abdullahsahruri/tinker/docs/poster/tinker_socc2026_poster.pdf

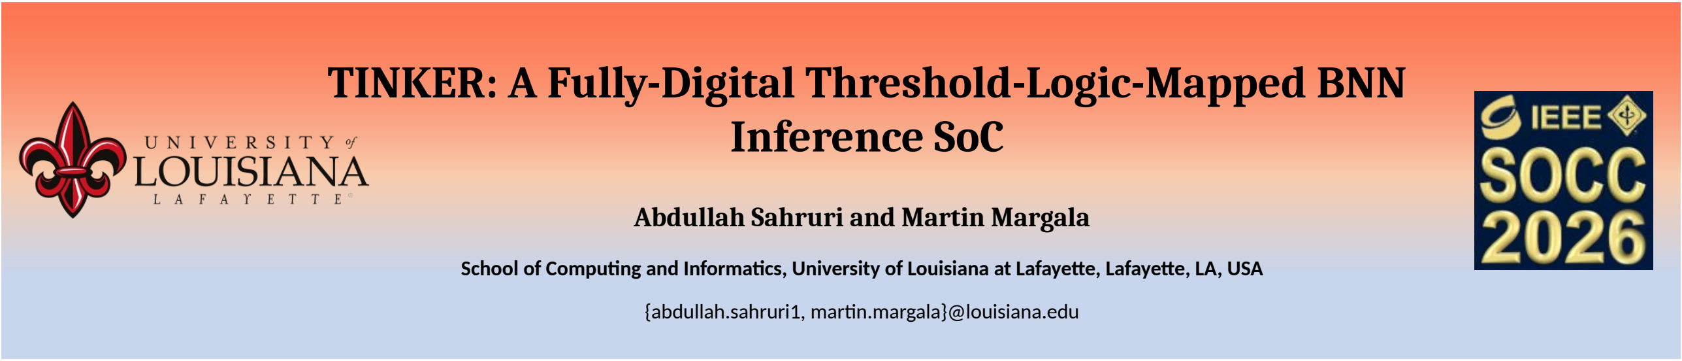
[picture p5: figure]
Inference SoC; Abdullah Sahruri and Martin Margala

# TINKER: A Fully-Digital Threshold-Logic-Mapped BNN

School of Computing and Informatics, University of Louisiana at Lafayette, Lafayette, LA, USA

## {abdullah.sahruri1, martin.margala}@louisiana.edu

85.60 %

## MNIST accuracy

full 10 000-image test set 95 % Wilson CI [84.90, 86.27]

# 8.06 µJ

## per inference

17 068 cycles, 170.7 µs
at 100 MHz

# 47.21 mW

## post-P&R SoC power

activity-aware, 2.25 mm² die, sky130A open flow

24.3 %

## of SoC power in the TLG tile

largest active datapath bucket

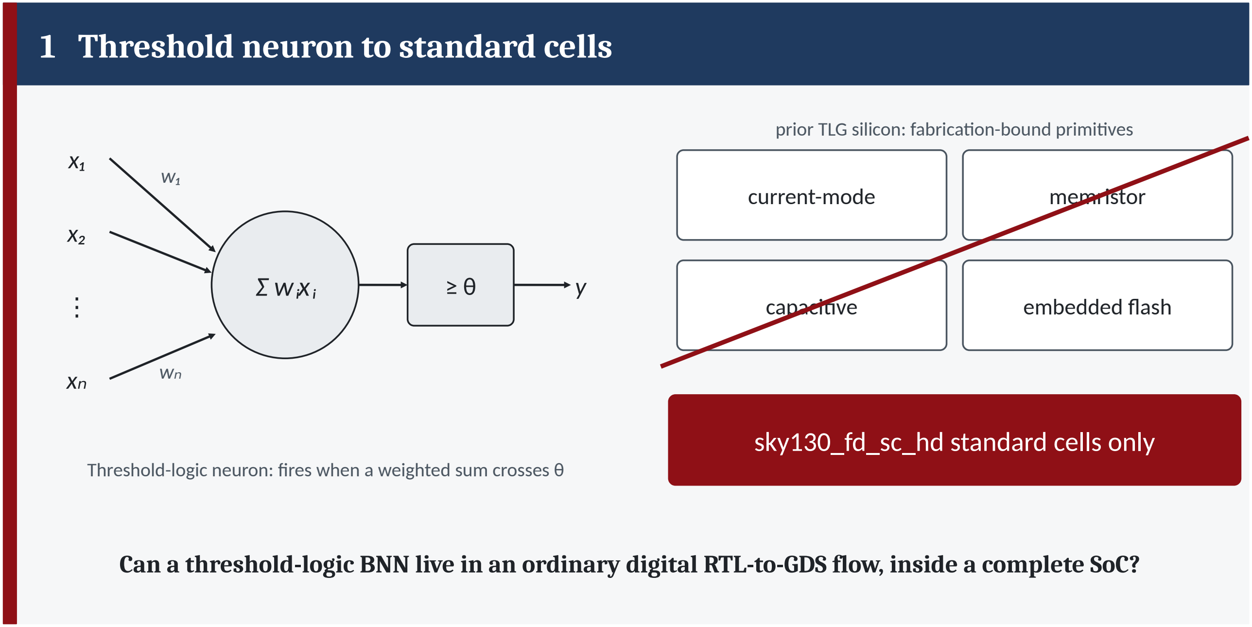
[picture p6: figure]
1 Threshold neuron to standard cells; Σ wᵢxᵢ; prior TLG silicon: fabrication-bound primitives; current-mode; memristor; capacitive; embedded flash; sky130_fd_sc_hd standard cells only

Threshold-logic neuron: fires when a weighted sum crosses θ

Can a threshold-logic BNN live in an ordinary digital RTL-to-GDS flow, inside a complete SoC?

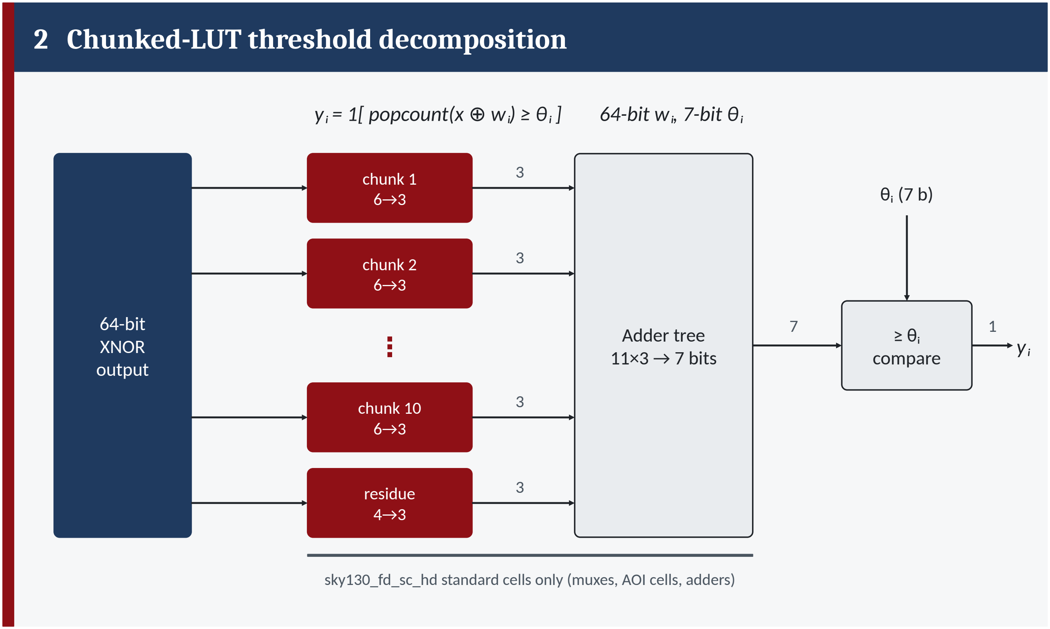
[picture p7: figure]
2 Chunked-LUT threshold decomposition; chunk 2 6→3

yᵢ = 1[ popcount(x wᵢ) ≥ θᵢ ] 64-bit wᵢ, 7-bit θᵢ ⊕ 3 chunk 1 θᵢ (7 b) 6→3 64-bit 7 1 Adder tree ≥ θᵢ ⋮ XNOR yᵢ 11×3 → 7 bits compare output 3 chunk 10 6→3 3 residue 4→3 sky130_fd_sc_hd standard cells only (muxes, AOI cells, adders)

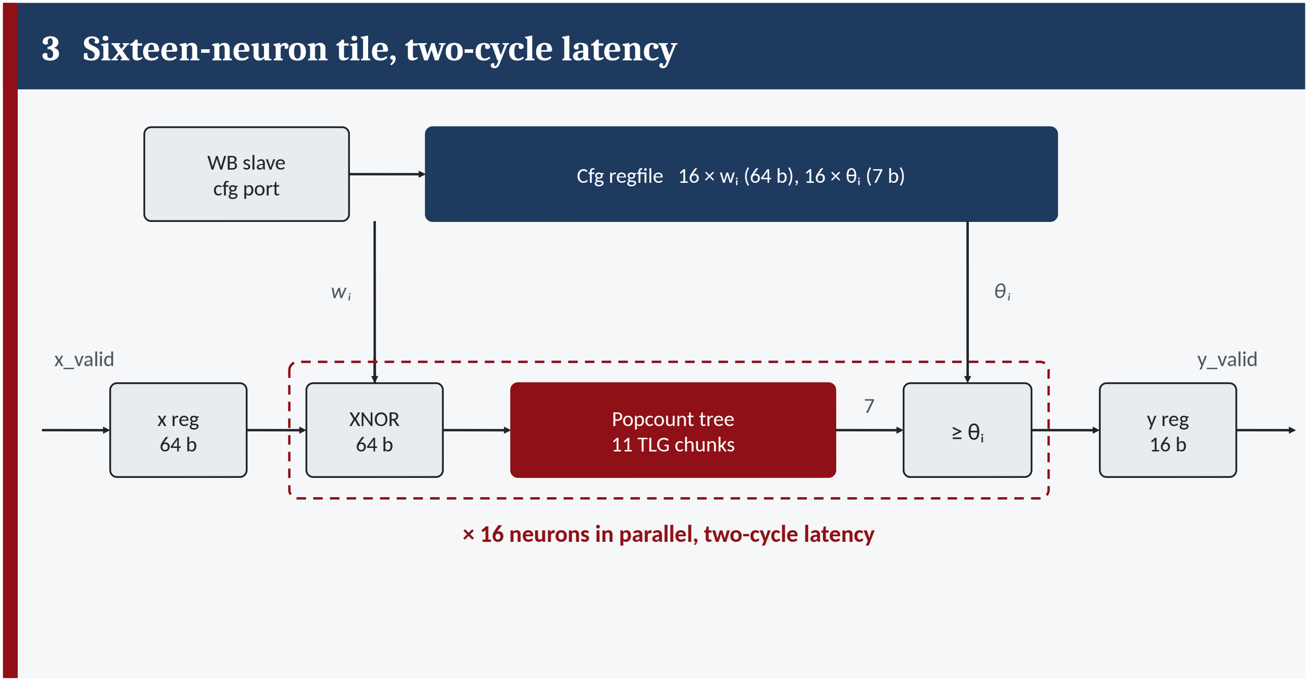
[picture p8: figure]
x_valid; y_valid

# 3 Sixteen-neuron tile, two-cycle latency

WB slave cfg port x reg XNOR 64 b 64 b | Cfg regfile 16 × wᵢ (64 b), 16 × θᵢ (7 b) 7 Popcount tree y reg 11 TLG chunks ≥ θᵢ 16 b × 16 neurons in parallel, two-cycle latency

# 4 Energy per inference vs. prior BNN silicon (log scale)

XNE, 22 nm | 51.2 % ImageNet
YodaNN, 65 nm | ~56 % ImageNet
TULIP (TLG, flash), 40 nm | 89.85 % CIFAR-10
TINKER, sky130A | 85.60 % MNIST, full open-flow SoC
OpenSpike (SNN), sky130 | 99.12 % MNIST, core only
ChewBaccaNN, 22 nm FDX | 86.8 % CIFAR-10
0.1 | 1 | 10 | 100 | 1000
| | µJ per inference

Nodes, networks and reporting scope differ; positioning, not a ranking. 124 113 inferences/J, 5 860 inf/s.

# 5 Post-P&R floorplan on sky130A, 1.5 × 1.5 mm die

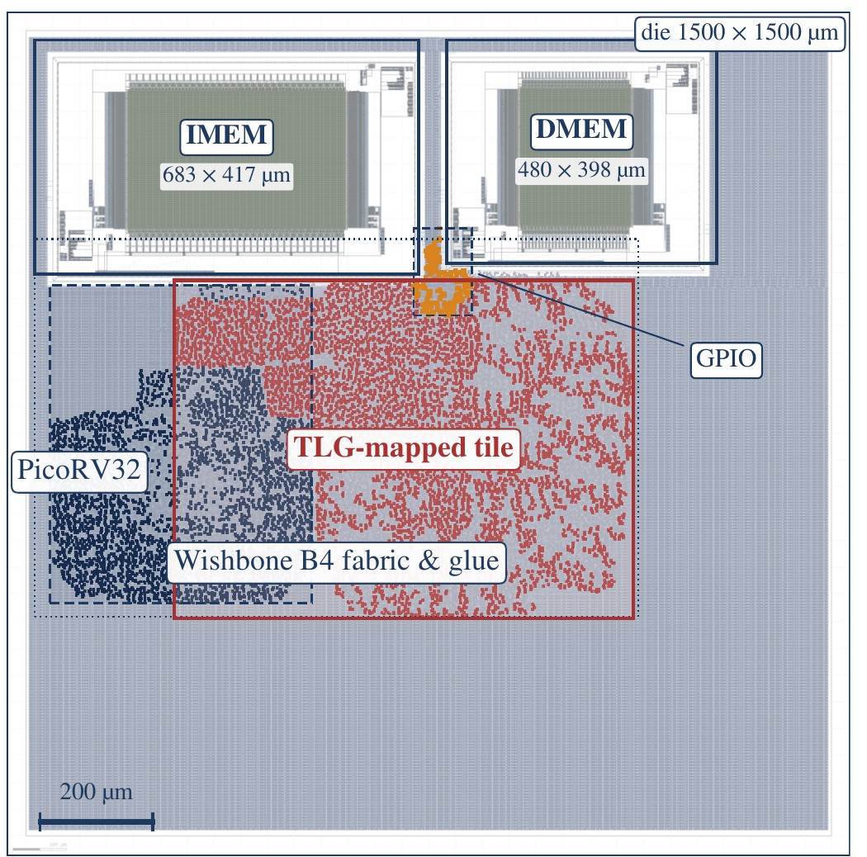
[picture p9: figure]

LibreLane flow: Yosys, OpenROAD, Magic, KLayout, Netgen. OpenRAM IMEM (2 KB) and DMEM (1 KB) macros top; TLG tile, PicoRV32, and fabric below. Nine-corner STA; TT closes at +0.51 ns setup, +0.37 ns hold.

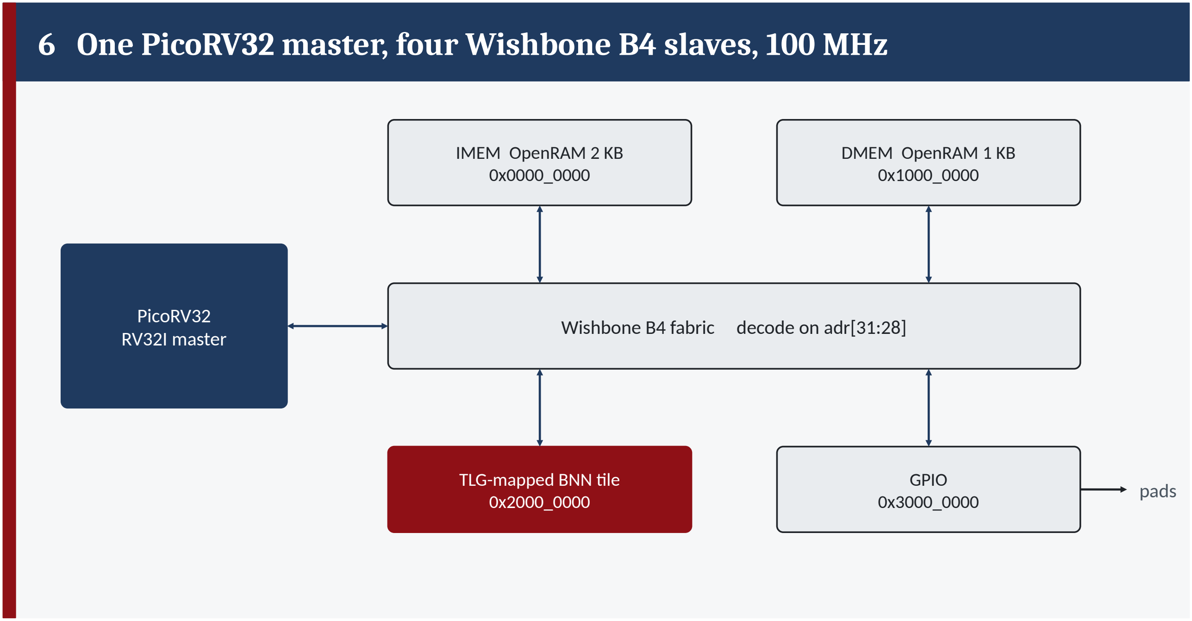
[picture p10: figure]

# 6 One PicoRV32 master, four Wishbone B4 slaves, 100 MHz

IMEM OpenRAM 2 KB DMEM OpenRAM 1 KB 0x0000_0000 0x1000_0000 PicoRV32 Wishbone B4 fabric decode on adr[31:28] RV32I master TLG-mapped BNN tile GPIO pads 0x2000_0000 0x3000_0000

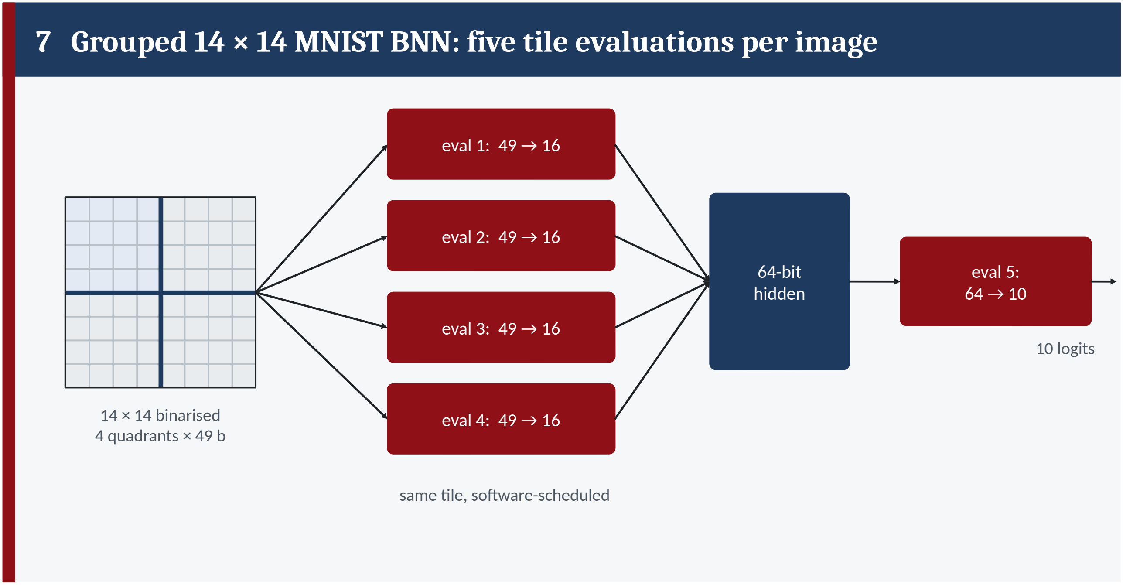
[picture p11: figure]
14 × 14 binarised 4 quadrants × 49 b; eval 2: 49 → 16; eval 3: 49 → 16; 64-bit hidden; eval 5: 64 → 10; 10 logits

# 7 Grouped 14 × 14 MNIST BNN: five tile evaluations per image

| eval 1: 49 → 16 eval 4: 49 → 16 same tile, software-scheduled
| 8 Where the SoC power goes (post-P&R, VCD-annotated)
| Register-file baseline (pre-OpenRAM): 106.06 mW
clock | 10.8 % | CPU | memory 36.4 %
clock | 24.3 % | CPU | mem | OpenRAM macros (this work): 47.21 mW same tile netlist, 11.47 mW
0 | 20 | 40 | 60 | 80 | 100 mW

OpenRAM halves SoC power; the unchanged tile rises from 10.8 % to 24.3 % and becomes the largest active datapath bucket.

IEEE 39th International System-on-Chip Conference (SOCC 2026), Heidelberg, Germany

paper + poster (Drive)
