abdullahsahruri/tinker/paper/figures/fig4_power_breakdown.pdf

0 | 20 | 40 | 60 | 80 | 100
Power (mW) at max_ff_n40C_1v95
| | 10.8% | | total 106.06 mW regfile baseline

same Tile RTL (11.47 mW)

| 24.3% | | total 47.21 mW OpenRAM macros

(pre-OpenRAM)

(this work)

Clock | Tile | CPU | IMEM | DMEM Shared | GPIO | Other
