abdullahsahruri/tinker/camera-ready/tables/table2_comparison.tex

% Table II — Comparison vs prior digital BNN/threshold-logic ASICs and
% the closest open-flow neural-inference comparator. Numeric cells for
% cited rows are populated from the cited papers' canonical PPA tables;
% see comments above each row for the verifying source.
\begin{table}[!t]
  \centering
  \caption{BNN/threshold-logic accelerator positioning. Designs differ in
  node, network, voltage, and reporting scope; the table is not a direct
  efficiency ranking. \textsuperscript{$\dagger$}~inherited training-method
  accuracy; \textsuperscript{$\ddagger$}~core dynamic energy only.}
  \label{tab:comparison}
  \scriptsize
  \renewcommand{\arraystretch}{1.15}
  \setlength{\tabcolsep}{3pt}
  \begin{tabular}{@{}llllll@{}}
    \toprule
    \textbf{Ref.} & \textbf{Tech.} & \textbf{Network} & \textbf{Acc.} & \textbf{E/inf.} & \textbf{Area} \\
    \midrule
    \cite{conti2018xnor}          & 22\,nm        & ResNet-18 IN     & 51.2\,\%               & 1\,450\,\textmu J               & 2.32\,mm$^2$ \\
    \cite{andri2018yodann}       & UMC 65\,nm    & AlexNet IN       & $\sim$56\,\%$^\dagger$ & 352\,\textmu J                  & 1.9\,mm$^2$  \\
    \cite{wagle2020tulip}            & 40\,nm        & BinaryNet C10    & 89.85\,\%$^\dagger$    & 184\,\textmu J                  & 1.8\,mm$^2$  \\
    \cite{andri2021chewbaccann}  & GF 22\,nm FDX & VGG-like C10     & 86.8\,\%               & 1.3\,\textmu J                  & 0.7\,mm$^2$  \\
    \cite{modaresi2023openspike}        & sky130        & 1024-1024-10 SNN & 99.12\,\%              & $\sim$2.5\,\textmu J$^\ddagger$ & 33.3\,mm$^2$ \\
    \midrule
    \textbf{This work}      & sky130A       & 14$\times$14 BNN & \textbf{85.60\,\%}     & \textbf{8.06\,\textmu J}        & 2.25\,mm$^2$ \\
    \bottomrule
  \end{tabular}
\end{table}
