abdullahsahruri/tinker/paper/figures/fig_tlg_decomp.pdf

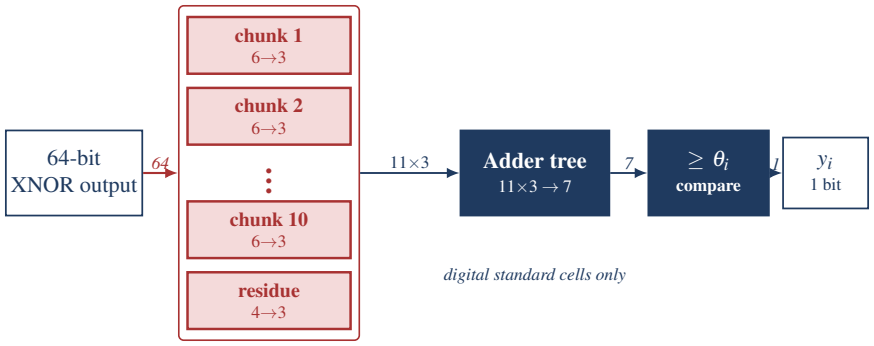
[picture p17: figure]
64-bit XNOR output; chunk 1 6→3; chunk 2 6→3 . . .; chunk 10 6→3; residue 4→3; Adder tree; compare; 1 bit; digital standard cells only
