abdullahsahruri/tinker/paper/figures/fig2_tile_microarch.pdf

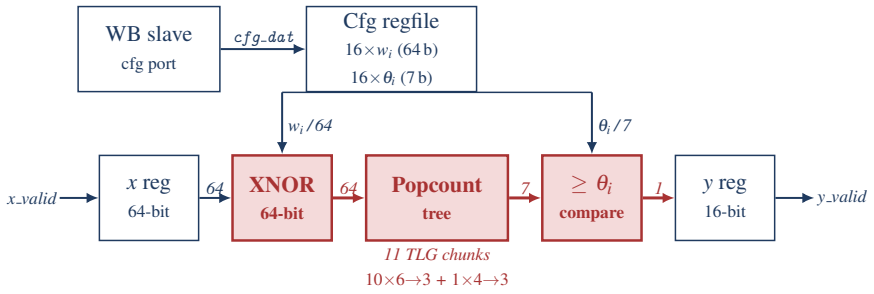
[picture p18: figure]
WB slave; cfg port; Cfg regfile; cfg dat; x reg; 64-bit; XNOR; Popcount; tree; compare; y reg; 16-bit; 11 TLG chunks; x valid; y valid

threshold function via TL decomposition (sky130 fd sc hd muxes & AOI cells)

## ×16 neurons in parallel → 16-bit output / cycle
