abdullahsahruri/tinker/paper/figures/fig1_soc_block.pdf

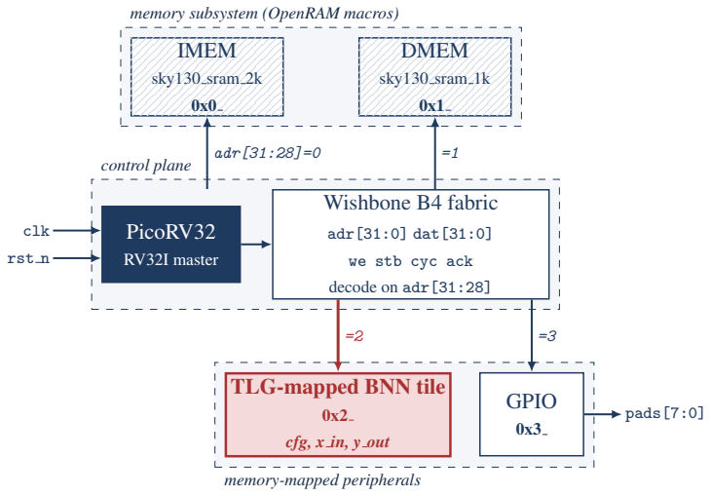
[picture p19: figure]
IMEM; sky130 sram 2k; DMEM; sky130 sram 1k; memory subsystem (OpenRAM macros); PicoRV32; RV32I master; Wishbone B4 fabric; adr[31:0] dat[31:0]; we stb cyc ack; decode on adr[31:28]; control plane; TLG-mapped BNN tile; cfg, x in, y out; GPIO; memory-mapped peripherals; adr[31:28]=0; clk; rst n; pads[7:0]
