abdullahsahruri/tinker/paper/figures/fig3_layout_v2_OLD.pdf

## IMEM

683 × 417 µm

## DMEM

480 × 398 µm

### TLG-mapped tile

681 × 503 µm

### PicoRV32

GPIO

Wishbone B4 fabric
routed across std-cell rows

die 1500 × 1500 µm

200 µm
