abdullahsahruri/tinker/paper/figures/fig3_layout_klayout_OLD.pdf

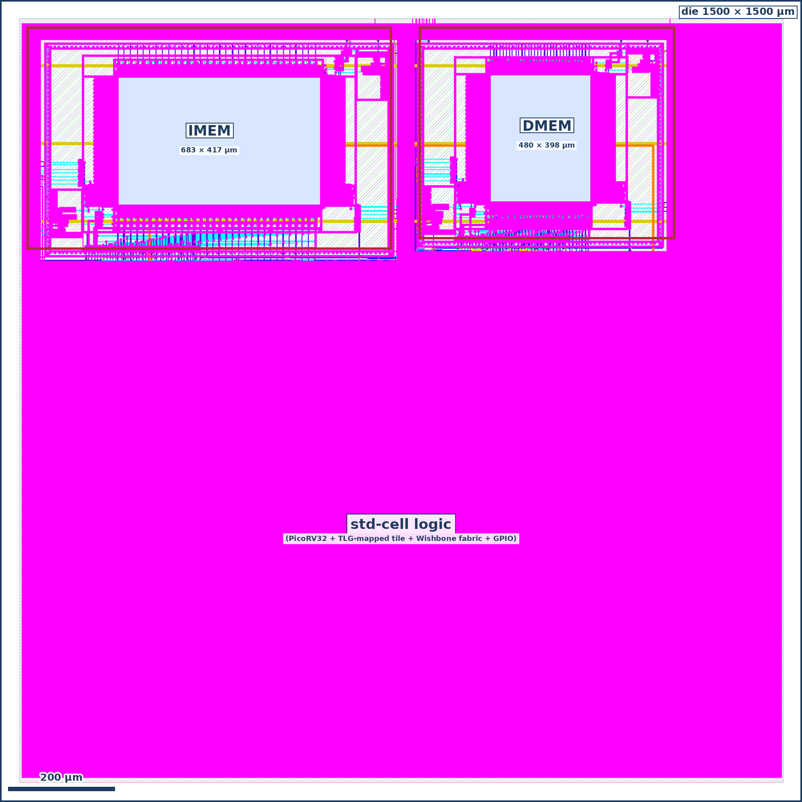
[picture p20: page 1]
