abdullahsahruri/tinker/paper/figures/src/fig3_base.png

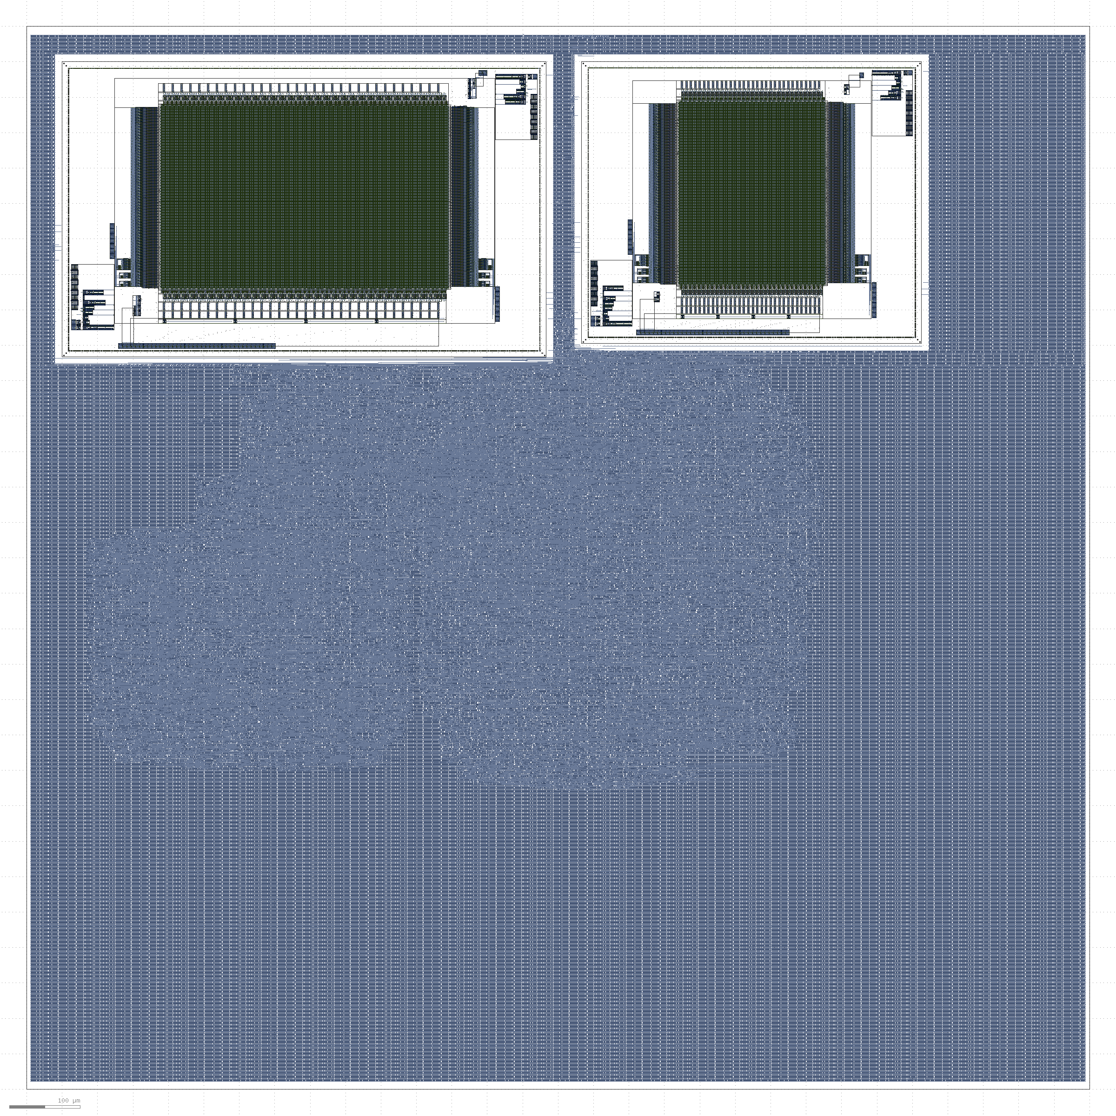
paper/figures/src/fig3_base.png
