abdullahsahruri/tinker/camera-ready/tables/table1_verification.tex

% Table I — Functional verification summary (4 gates).
% Numbers locked from PHASE4_5_NOTES.md §6 and PHASE3_5_NOTES.md §3.
\begin{table}[t]
  \centering
  \caption{Functional verification summary.}
  \label{tab:verification}
  \renewcommand{\arraystretch}{1.15}
  \begin{tabular}{@{}>{\raggedright\arraybackslash}p{0.36\columnwidth}>{\raggedright\arraybackslash}p{0.27\columnwidth}>{\raggedright\arraybackslash}p{0.27\columnwidth}@{}}
    \toprule
    \textbf{Gate} & \textbf{Reference} & \textbf{Result} \\
    \midrule
    PyTorch $\leftrightarrow$ integer golden & integer model & 15/16 (1 boundary) \\
    SoC sim $\leftrightarrow$ integer golden & RTL simulation & 16/16 PASS         \\
    Full MNIST 10\,K eval                    & vectorized integer model    & 85.60\,\% [84.90, 86.27] \\
    DRC / LVS / XOR / antenna               & KLayout, Netgen             & 0 / 0 / 0 / 0      \\
    \bottomrule
  \end{tabular}
\end{table}
