abdullahsahruri/tinker/results/phase4_prep/full_mnist_accuracy_14x14.md

# Phase 4.5 Stage 1 — Full MNIST Test-Set Accuracy

**Network**: 4×(49→16,BN,sign)→64→10 grouped BNN (14×14 grouped preprocessing, hard-tanh STE, OneCycleLR 30 ep, 3-seed best).

## Headline Result

| Metric | Value |
|---|---|
| Test images | 10,000 |
| Correct | 8,560 |
| **Accuracy** | **85.60%** |
| 95% Wilson CI | [84.90%, 86.27%] |
| Phase-3D 7×7 BNN | 71.12% |
| Phase-4.5 initial 14×14 | 80.73% |
| Delta vs initial | +4.87 pp |

## Per-Class Accuracy

| Digit | Correct | Total | Accuracy |
|---|---|---|---|
| 0 | 900 | 980 | 91.8% |
| 1 | 1080 | 1135 | 95.2% |
| 2 | 876 | 1032 | 84.9% |
| 3 | 864 | 1010 | 85.5% |
| 4 | 787 | 982 | 80.1% |
| 5 | 670 | 892 | 75.1% |
| 6 | 871 | 958 | 90.9% |
| 7 | 889 | 1028 | 86.5% |
| 8 | 782 | 974 | 80.3% |
| 9 | 841 | 1009 | 83.3% |

## Confusion Matrix

Rows = true class, columns = predicted class.

| True \ Pred | 0 | 1 | 2 | 3 | 4 | 5 | 6 | 7 | 8 | 9 |
|---|---|---|---|---|---|---|---|---|---|---|
| **0** | 900 | 1 | 11 | 14 | 3 | 3 | 14 | 4 | 30 | 0 |
| **1** | 0 | 1080 | 11 | 1 | 1 | 9 | 8 | 2 | 23 | 0 |
| **2** | 15 | 8 | 876 | 20 | 14 | 3 | 19 | 18 | 53 | 6 |
| **3** | 16 | 5 | 27 | 864 | 3 | 24 | 11 | 19 | 25 | 16 |
| **4** | 3 | 5 | 12 | 5 | 787 | 7 | 24 | 13 | 14 | 112 |
| **5** | 26 | 17 | 11 | 68 | 27 | 670 | 22 | 4 | 30 | 17 |
| **6** | 25 | 3 | 11 | 3 | 7 | 27 | 871 | 4 | 6 | 1 |
| **7** | 7 | 12 | 23 | 9 | 13 | 3 | 1 | 889 | 18 | 53 |
| **8** | 18 | 8 | 26 | 57 | 8 | 35 | 14 | 12 | 782 | 14 |
| **9** | 13 | 7 | 5 | 16 | 44 | 6 | 1 | 54 | 22 | 841 |

*Eval time: 0.1s on CPU.*
