abdullahsahruri/tinker/results/phase1/summary.csv

variant | seed | area_um2 | stdcell_count | fmax_mhz | power_uw_at_100mhz | ws_at_slow_ns | drc_errors | lvs_errors | run_dir
naive | 0 | 8051.47 | 492 | 110.27513865626167 | 3084.24886316061 | 0.931772907426604 | 0 | 0 | flow/phase1_naive/seed0/runs/phase1_naive_s0
naive | 1 | 8051.47 | 493 | 108.93401226414832 | 3240.9646082669497 | 0.820130653269679 | 0 | 0 | flow/phase1_naive/seed1/runs/phase1_naive_s1
naive | 2 | 8051.47 | 502 | 99.89087326782106 | 2951.8872033804655 | -0.010924594871280184 | 0 | 0 | flow/phase1_naive/seed2/runs/phase1_naive_s2
naive | 3 | 8051.47 | 490 | 111.49400422581039 | 3251.7046201974154 | 1.0309078327235803 | 0 | 0 | flow/phase1_naive/seed3/runs/phase1_naive_s3
naive | 4 | 8092.76 | 498 | 99.1800620657252 | 3043.002914637327 | -0.08267164964380158 | 0 | 0 | flow/phase1_naive/seed4/runs/phase1_naive_s4
handopt | 0 | 7767.45 | 494 | 105.53117846091443 | 3011.635970324278 | 0.5241274229646753 | 0 | 0 | flow/phase1_handopt/seed0/runs/phase1_handopt_s0
handopt | 1 | 8051.47 | 502 | 104.03753270606951 | 3030.611900612712 | 0.3880842423932235 | 0 | 0 | flow/phase1_handopt/seed1/runs/phase1_handopt_s1
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
