abdullahsahruri/tinker/results/phase2/summary.csv

variant | seed | cells | area_um2 | fmax_mhz_slow | fmax_mhz_nom | ws_slow_ns | power_total_uw | power_internal_uw | power_switching_uw | power_leakage_uw | drc_violations | lvs_violations | antenna_nets | antenna_pins | run_dir
tlg_hc | 0 | 7184 | 116049.0 | 89.02273422577599 | 146.11681605335892 | -1.2330856684747389 | 26637.7255320549 | 14245.596714317799 | 12392.021715641022 | 0.10854230225731953 | 0 | 0 | 0 | 0 | flow/phase2_tlg_hc/runs/phase2_tlg_hc
tlg_hc | 1 | 7150 | 117765.0 | 85.82350180316844 | 141.62767182868498 | -1.6518200608202394 | 27364.056557416916 | 14622.378163039684 | 12741.568498313427 | 0.11045993630887097 | 0 | 0 | 0 | 0 | flow/phase2_tlg_hc/seed1/runs/phase2_tlg_hc_s1
tlg_hc | 2 | 7124 | 115580.0 | 88.45547156448728 | 143.43722851318134 | -1.3051231575987163 | 26900.874450802803 | 14243.443496525288 | 12657.32292085886 | 0.1077615650046937 | 0 | 0 | 0 | 0 | flow/phase2_tlg_hc/seed2/runs/phase2_tlg_hc_s2
tlg_ld | 0 | 22125 | 320367.0 | 73.81119119452518 | 130.41260815197037 | -3.54808104050993 | 64565.9938454628 | 34599.486738443375 | 29966.194182634354 | 0.3153805891997763 | 0 | 0 | 0 | 0 | flow/phase2_tlg_ld/runs/phase2_tlg_ld
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
