abdullahsahruri/tinker/results/phase3/figures/soc_layout_openram_raw.png

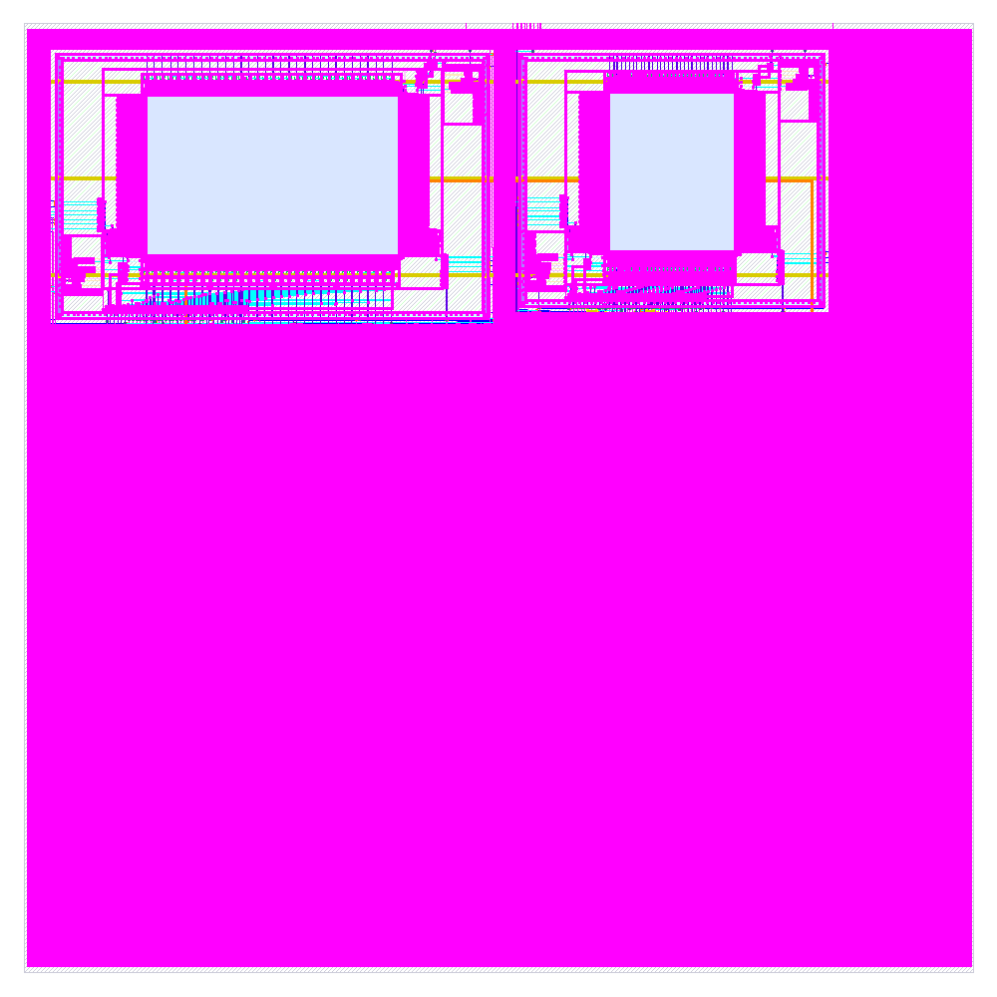
results/phase3/figures/soc_layout_openram_raw.png
