abdullahsahruri/tinker/paper/figures/conventional3.pdf

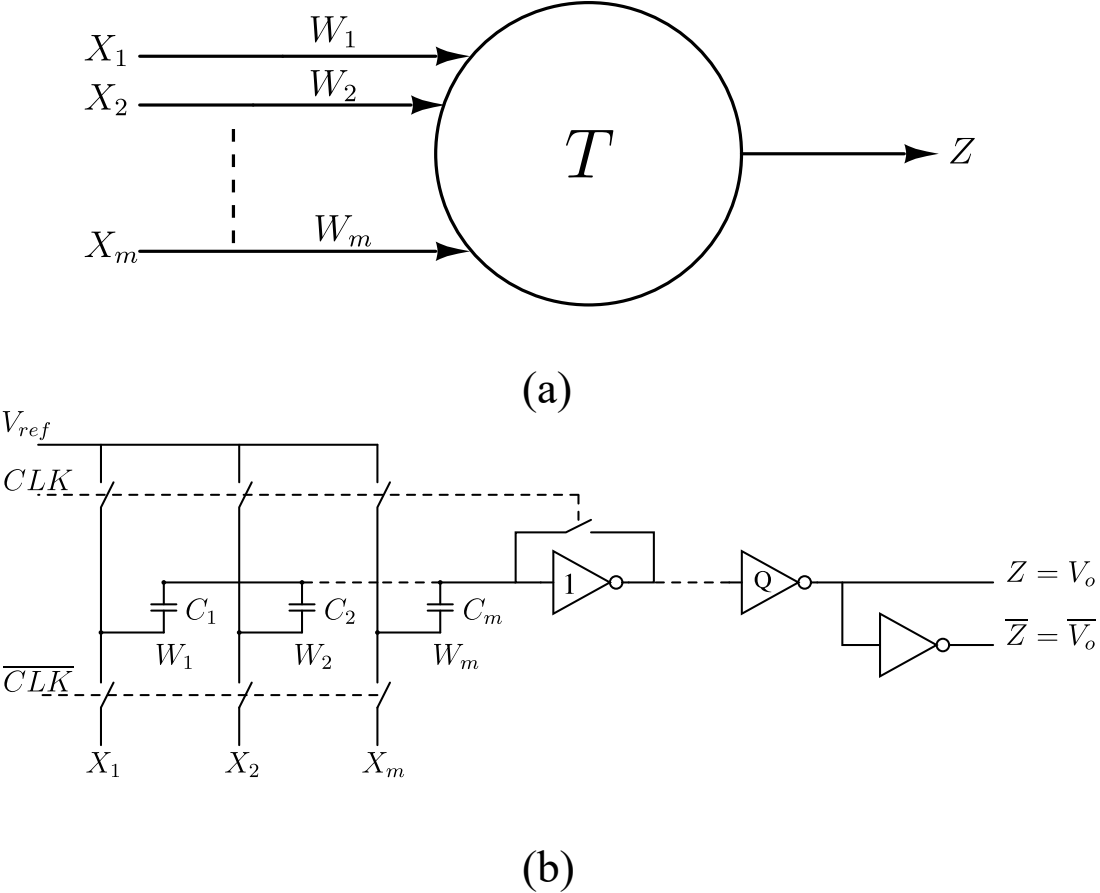
[picture p23: page 1]
