abdullahsahruri/tinker/(commit log)

2026-05-02 Phase 0 complete: toolchain, env.sh, hello-world GDS
    - LibreLane 3.0.3 installed in .venv/, Docker image pulled
    - sky130A PDK at commit 8afc8346a57fe1ab7934ba5a6056ea8b43078e71
    installed locally to ./pdk/ via volare 0.20.6
    - scripts/env.sh: project-local activation, scrubs /mnt/c PATH pollution
    (no system-wide changes)
    - rtl/hello.v + flow/hello/config.json: 4-bit counter end-to-end smoke test
    - results/hello/{hello.gds,metrics.json}: 0 DRC, 0 LVS, +5.46 ns setup slack
    - docs/PHASE0_NOTES.md: pinned versions, .wslconfig RAM advisory for Phase 2
2026-05-03 Phase 1 complete: 15-run TLG vs naive vs hand-opt PPA study
    15 LibreLane flows (3 variants × 5 seeds) all DRC/LVS clean. Headline:
    - Area: C +19% larger than B, +17% larger than A
    - Fmax: C 3% slower than B
    - Power: C 48% lower than B, 51% lower than A
    NO-GO on strict ≥20%-on-≥2-of-3 criterion: TLG wins only on power.
    Power result is large enough to consider re-framing as energy-first.
    Deliverables:
    - scripts/{gen_neuron,gen_tb_data,run_phase1,collect_phase1}.{py,sh}
    - rtl/{naive,handopt,tlg}/neuron_*_s{0..4}.v
    - tb/tb_neuron_s0.v + golden vectors (100/100 match for seed=0)
    - flow/phase1_{naive,handopt,tlg}/{config.json,seed*/}
    - flow/common/neuron.sdc (combinational virtual-clock S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
    [summary.csv]
2026-05-03 Phase 2B: tile-level LibreLane PPA — TLG energy advantage composes
    Four LibreLane runs on sky130A/sky130_fd_sc_hd, identical knobs
    (SYNTH_STRATEGY=AREA 0, FP_CORE_UTIL=35, PL_TARGET_DENSITY_PCT=55),
    new sequential-clock SDC at flow/common/tile.sdc. All four DRC/LVS/
    antenna clean.
    Headline:
    TLG_hc vs handopt_hc: -28.1% power, -31.5% cells, -11.6% area
    TLG_ld vs handopt_ld: -61.5% power (iso-cell, iso-area, iso-Fmax)
    The loadable comparison — the one that matters for a programmable
    tile — beats Phase 1's per-neuron 48% advantage. Hardcoded gap
    (28.1%) is 1.9 pp shy of the strict GO threshold; full GO/MARGINAL
    discussion and Session 2C path forward are in docs/PHASE2B_NOTES.md.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
    [summary.csv]
2026-05-03 Phase 2B.5: 3-seed sweep confirms TLG hc advantage; ≥30% gate passes
    4 new LibreLane runs (tlg_hc, handopt_hc × seed_id 1, 2) on top of
    2B's seed-0 baseline. Loadable variants skipped — their RTL is
    seed-invariant by construction (no weight constants in the .v
    file), so synthesis-time PPA is identical for any seed.
    Headline movement vs single-seed 2B:
    TLG hc vs handopt hc — power: 28.1% → 31.3% (crosses ≥30% gate)
    TLG hc vs handopt hc — cells: 31.5% → 32.0%
    TLG hc vs handopt hc — Fmax: 2.4% → 5.8%
    TLG ld vs handopt ld — power: 61.5% (unchanged, seed-invariant)
    Per-seed picture is dominant: every TLG hc run beats every
    handopt hc run on every measured axis.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
    [summary.csv]
2026-05-03 Phase 2C: activity-aware power — TLG hc resilience widens, ld holds gate
    Two complementary mechanistic findings on the same post-route netlists
    from 2B/2B.5 (no re-synthesis), driven by VCD-extracted boundary
    activity from 1024 random-uniform 64-bit vectors at 1+2 cadence.
    hc — TLG advantage WIDENS 31.2% → 80.25% ± 0.68% (3-seed mean).
    Truth-table case-arms suppress combinational toggle propagation;
    adder-tree carry chains glitch on every input change. 9.6×
    combinational power explosion on handopt_hc vs 3.4× on TLG_hc
    drives the +49 pp jump.
    ld — TLG advantage SHRINKS 61.5% → 49.07% ± 0.10% (3-seed mean).
    ~1100-flop cfg regfile creates an activity-invariant powe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
    [summary.csv]
2026-05-04 Phase 3A: SoC architecture spec + skeleton RTL
    Architecture locked: PicoRV32 RV32I master + Wishbone B4 classic single
    shared bus + 4 slaves (IMEM 8 KB @ 0x0, DMEM 4 KB @ 0x1, TILE 512 B @ 0x2,
    GPIO 16 B @ 0x3), single clock domain, async-assert / sync-deassert reset,
    polled inference handshake on STATUS.BUSY. Address decode on adr[31:28].
    PicoRV32 ↔ WB glue uses upstream picorv32_wb wrapper (vendored in 3C).
    Tile wrapper register bank (PHASE3_ARCHITECTURE.md §4): two-write commit
    for 64-bit weights (LO at 0x000+8i, HI at 0x004+8i — writing HI commits
    to tile cfg via one cfg_we pulse) and for the 64-bit input vector (LO at
    0x100, HI at 0x104 — writing HI pulses x_valid). Thresholds p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
    [picorv32_wrapper.v, soc_top.v, wb_dmem.v, wb_gpio.v, wb_imem.v, wb_interconnect.v, wb_tile_wrapper.v]
2026-05-04 Phase 3B: tile wrapper RTL + bus-level TB — 10/10 PASS
    Replace the 3A skeleton body of wb_tile_wrapper.v with the full Wishbone
    B4 classic slave specified in PHASE3_ARCHITECTURE.md §4. Verify against
    a directed bus-level testbench that exercises ten scenarios; all pass on
    first run.
    Wrapper implementation (~210 LoC body):
    - Registered 1-cycle ack pulse on the first stb cycle. Reads are
    combinational mux from wb_adr_i; data is valid in the cycle ack
    pulses, so all transactions complete in 2 cycles.
    - 16x32 w_lo + 16x32 w_hi + 16x7 t_shadow + 32 xin_lo + 32 xin_hi
    register-file shadows. cfg_we and tile_x_valid pulse for one
    cycle on the same edge that the bus_wr is acke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
    [tb_wb_tile_wrapper.sv, wb_tile_reference.py, wb_tile_wrapper.v]
2026-05-04 Phase 3C: PicoRV32 vendored + SoC bring-up — 102-cycle smoke PASS
    PicoRV32 vendored at upstream commit 87c89ac (vendor/picorv32/picorv32.v).
    The 3A skeletons for picorv32_wrapper, wb_interconnect, wb_imem, wb_dmem,
    and wb_gpio are now real implementations honoring the §3.4 parameter
    table; wb_tile_wrapper is unchanged from 3B.
    A 13-instruction bare-metal smoke firmware (firmware/smoke/) writes 0xBE
    to GPIO_OUT and the 0xCAFEBABE sentinel to GPIO_SIM_END. End-to-end
    testbench (tb/tb_soc_smoke.sv) sees both observables in 102 simulated
    cycles / 14 acked WB transactions, with the trace confirming all
    fetches go through IMEM and both stores reach GPIO. All three gates
    green: 3A elab, 3B tile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
2026-05-04 Phase 3D: end-to-end BNN inference firmware — SoC PASS 16/16
    49→64→10 BinaryConnect-style MNIST BNN trained from scratch in
    PyTorch (test_acc 0.7127), exported as int8 ±1 weights with
    γ-sign-aware BN1 fold, compiled into ~1.5 KB of bare-metal RV32I
    firmware that drives the Phase-2C tile_tlg_ld accelerator across
    4 hidden-layer evaluations per image (output layer in software,
    since argmax needs pre-threshold sums). The integration TB runs
    234 638 cycles / 40 301 WB transactions and matches the Python
    golden on 16 of 16 MNIST images, beating the 14/16 floor.
    Headline diagnostic: the v1 spec-locked preprocessing (avg-pool +
    fixed-0.5 binarize) capped any classifier at ~70 % on this 7×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
    [bnn_reference.py, diagnose_float_128.py, gen_bnn_testdata.py, main.c, tb_soc_bnn.sv, train_bnn.py, weights_to_c.py]
2026-05-04 Phase 3E baseline: full SoC LibreLane P&R + activity-aware power
    Register-file-IMEM SoC baseline data point (Path B per session
    brief). Headline numbers: 1.77 mm² die, 49 % util, 100 MHz at
    nom_tt with +1.95 ns slack, 90 mW activity-aware power at nom_tt
    / 106 mW at max_ff (15.6 µJ per inference at max_ff). DMEM regfile
    + clock tree dominate (~80 % of total), confirming the
    architecture spec's no-OpenRAM-IMEM-tax prediction. Slow-corner
    setup does not close (-5.32 ns WNS) due to a 4 484-fanout IMEM
    read-mux that survives even after shrinking IMEM 8 KB → 2 KB and
    DMEM 4 KB → 1 KB; this is the structural motivation for the
    follow-up Session 3.5 OpenRAM-backed run, which will become the
    p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
2026-05-04 Phase 3.5: OpenRAM SRAM macro integration — tile fraction 10.81% → 24.29%
    Replace the register-file IMEM (2 KB) and DMEM (1 KB) of the Session-3E
    baseline with pre-hardened sky130_sram_macros from the sky130A PDK.
    wb_imem and wb_dmem rewritten as Wishbone-classic wrappers around the
    macros with a 2-state wait-state FSM (1-cycle macro read latency
    absorbed via dout0_q latch). soc_top INIT_HEX parameter no longer
    forwarded; sim firmware loads via -DIMEM_INIT_HEX iverilog define
    inside `ifdef __ICARUS__ block. Macros instantiated as direct
    soc_top children (keep_hierarchy removed for LibreLane 3.x macro
    support). LibreLane config takes 7 attempts to converge — config-
    syntax + Verilator-p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
    [comparison_baseline_vs_openram.csv, macro_placement.cfg]
2026-05-04 Phase 4.5: grouped 14×14 BNN — 85.60% MNIST, 8.06 µJ/image, 16/16 SoC PASS
    Hard-tanh STE + OneCycleLR (30 ep, 3-seed) raises MNIST accuracy from 71.12%
    (Phase 3D 7×7) to 85.60% [84.90%, 86.27% Wilson 95% CI] at only +1.0% energy
    overhead (8.06 µJ vs 7.98 µJ). SoC netlist is byte-identical to Phase 3.5 —
    only firmware weights and DMEM layout changed (8 words/image for 4-quadrant
    14×14 vs 2 words/image for 7×7). Activity-aware power confirmed unchanged at
    47.21 mW @ max_ff_n40C_1v95 (47.21 mW Phase 3.5).
    Key changes:
    - scripts/train_bnn.py: hard-tanh STE (Hubara 2016), OneCycleLR, 3-seed sweep
    - firmware/inference: weights_14x14.h, 8-words/image DMEM layout in main.c
    - tb/tb_soc_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
    [comparison_baseline_vs_openram.csv]
2026-05-05 Phase 4: Section II Related Work drafted
    Two-paragraph related-work survey: para 1 covers commercial-PDK
    digital BNN accelerators (YodaNN/XNE/ChewBaccaNN/TULIP) with their
    node-and-voltage advantages; para 2 positions this work in the
    open-flow regime alongside OpenSpike, with a passing nod to FINN
    as a separate FPGA-side design point.
2026-05-05 Phase 5: Section VI Discussion and Section VII Conclusion drafted
    VI (~292 w): tile-fraction takeaway as the system-integration finding,
    honest open-flow energy tradeoff vs commercial-flow accelerators,
    methodology caveats around TT-only macro Liberty and activity-aware
    power, brief out-of-scope statement. VII (~107 w): three-line
    contribution restatement plus a forward-looking sentence on
    tile-level optimisation and tape-out.
2026-05-05 Phase 6: Section I Introduction drafted
    468w introduction with hook (commercial-flow BNN landscape and the
    open-flow gap), approach (TLG decomposition + PicoRV32 SoC + grouped
    14x14 BNN), five-point contributions list (inline numbered prose,
    not a bullet list), and section roadmap.
2026-05-05 Phase 7: Abstract drafted (153 words)
    Five-sentence abstract: open-flow framing, design summary, headline
    result with Wilson CI, system-level finding (tile fraction at
    24.3 percent), and contribution claim.
2026-05-05 fig4: power breakdown
2026-05-05 fig3: base render fixed -- std-cell texture visible
    [fig3_render_base.py]
2026-05-05 fig3: add Wishbone B4 fabric & glue overlay covering top-level cells
2026-05-05 rev2: section II — TULIP primary comparator, OpenSpike single-sentence
2026-05-05 rev2: Section V-D — TULIP primary, OpenSpike secondary
2026-05-05 rev2: Section VI refocus — architectural rather than energy claim
2026-05-05 rev2: polarity flip — system as contribution, named TINKER
2026-05-05 rev3: V-B replace open-flow advocacy with system finding
2026-05-05 rev3: tighten OpenSpike to system-level transition
2026-05-05 rev4: Section II — TLG lineage leads, BNN landscape secondary
2026-05-05 rev4: Section III restructure — III-A trim, III-B TLG technical center, III-C trim
2026-09-24 SOCC 2026 camera-ready: final paper edits and camera-ready package
    - paper/: SOCC reviewer edits, TLG decomposition figure redraw,
    conventional-TLG figure (conventional3.pdf), tile ablation table
    - camera-ready/: IEEE camera-ready sources, Makefile (make dist),
    submission checklist
2026-09-24 camera-ready: resolve known issues from review
    - Table I: sign-off row lists DRC/LVS/XOR/antenna to match Sec. V-B;
    ragged-right columns
    - Sec. VI-B: disclose 1.98 mW unbucketed remainder, wrapper inside the
    tile bucket, 47/1210 VCD net match rate, and 7x7-workload activity trace
    - Sec. VI-D: state slow-corner tile Fmax (73.81/77.51 MHz) vs 100 MHz
    - American spelling throughout
    - Fig. 6: drop colliding 47.21 tick; distinct color for "Other"
    - Trim redundant sign-off recap (Sec. VII) and Sec. II-B closer to hold 6 pages
    [fig4_power_breakdown.py]
2026-09-24 Add interactive web explainer (GitHub Pages)
    Scroll-driven walkthrough of the chunked-LUT TLG decomposition, tile, SoC
    bus transactions, and power results, plus an in-browser run of the deployed
    14x14 network (site/bnn.js is bit-exact with scripts/bnn_reference.py on all
    10,000 MNIST test images). No dependencies, no build step, no trackers.
